arlaneenalra/pi-pico-boards/README.md

# pi-pico-boards
A place to keep various pi-pico-board experiments
