arlaneenalra/pi-pico-boards/reworked/frankless/production/bom.csv

Designator | Footprint | Quantity | Value | LCSC Part #
C1, C10, C11, C12, C15, C18, C19, C20, C21, C22, C23, C24, C25, C26, C28, C36, C37, C38, C39, C42, C43, C5, C6, C9 | 0402 | 24 | 100n | C1525
C13, C14 | 0603 | 2 | 4.7u | C19666
C16, C17 | 0402 | 2 | 4.7u | C2986286
C2, C27, C29, C3, C30, C31, C32, C34, C35, C40, C44 | 0402 | 11 | 10uf | C77000
C33 | CP_EIA-3216-18_Kemet-A | 1 | 10uf tantulum | C7171
C4, C7 | 0603 | 2 | 10uf | C96446
C41 | 0402 | 1 | 1uf | C14445
C8 | 0603 | 1 | 22uf | C59461
D1 | D_SOD-323 | 1 | 1N5819WS | C191023
J2 | JST_SH_1x03_P1.00mm_Vertical | 1 | DEBUG | C160389
J3 | microSD_HC_Molex_104031-0811 | 1 | 1040310811 | C585350
J6 | HDMI-SMD_HC-HDMI0019T-2 | 1 | HC-HDMI0019T-1A | C51927036
J7 | AudioJack_3.5mm_PJ320D | 1 | PJ-320D | C431535
L1 | 0603 | 1 | 120R | C14709
L2 | AOTA-B201610S3R3-101-T | 1 | 3.3u | C42411119
LD1 | 0603 | 1 | KT-0603R | C2286
LD2 | 0603 | 1 | KT-0603W | C2290
R1, R10, R11, R3, R4, R5 | 0402 | 6 | 22R | C25092
R12 | 0402 | 1 | 0R | C17168
R13, R14, R2, R23, R24, R25, R26, R27, R28, R34, R36, R37, R38, R39, R40 | 0402 | 15 | 10K | C25744
R15 | 0402 | 1 | 33R | C25105
R16, R17, R9 | 0402 | 3 | 1K | C11702
R18, R19 | 0201 | 2 | 27R | C473051
R20, R33 | 0402 | 2 | 100R | C25076
R21, R22 | 0402 | 2 | 470R | C25117
R29, R30 | 0402 | 2 | 47K | C25792
R31, R32 | 0402 | 2 | 20K | C25765
R35, R60, R61 | 0402 | 3 | 4.7K | C25900
R6, R7 | 0402 | 2 | 5.1K | C25905
R8 | 0402 | 1 | 1M | C26083
RN1, RN2 | R_Array_Convex_4x0402 | 2 | 270R | C728722
S1 | Switch_Slide_MSK12C02 | 1 | MSK12C02 | C431540
S3, S4 | SW-SMD_4P-L3.5-W3.0-P1.50-LS4.7 | 2 | BUTTON | C49393608
U1 | UQFN-10 | 1 | TS3USB221RSER | C130085
U10 | SOIC-8_3.9x4.9mm_P1.27mm | 1 | DS3231MZ+TRL | C107410
U11 | QSOP-16_3.9x4.9mm_P0.635mm | 1 | CH334R | C4154405
U2 | SOT-23-6 | 1 | USBLC6-2SC6 | C2687116
U3 | SOT-223-3_TabPin2 | 1 | AMS1117-3.3 | C6186
U5 | SOIC-8_L4.9-W3.9-P1.27-LS6.0-BL | 1 | APS6404L-3SQR-SN | C5333729
U6 | SOIC-8 | 1 | W25Q128JVS | C97521
U7 | QFN-60_RP2350A | 1 | RP2350 | C42411118
U9 | SO-8 | 1 | LM358 | C7950
USB1 | USB-A-TH_AF-SS-JB17.6 | 1 | AF SS-JB17.6 | C456021
USB2 | USB-C-SMD_GT-USB-7010B | 1 | USB4215-03-A | C37616412
Y1, Y3 | OSC-SMD_4P-L1.6-W1.2-BL | 2 | ASE-12MHz | C20539386
