arlaneenalra/pi-pico-boards/reworked/frankless/3d/USB_A_Stacked.step

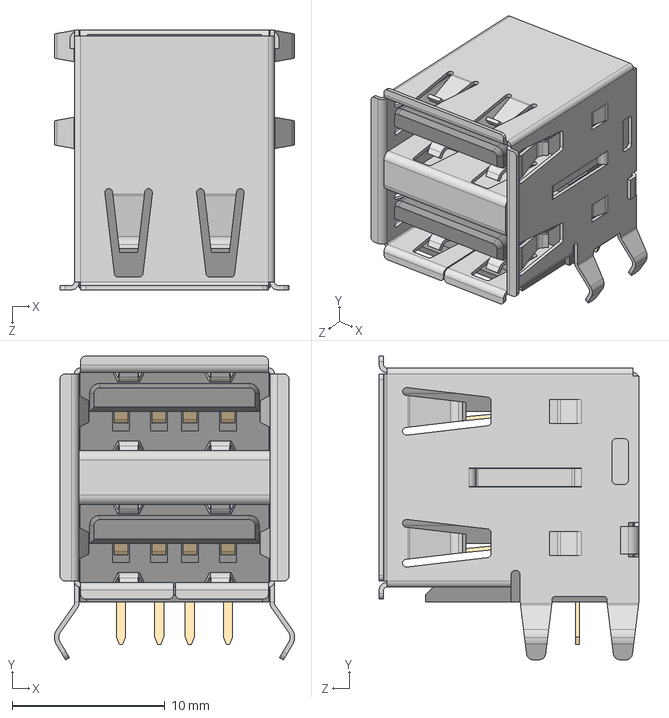
[picture p1: CAD file, 2026-10-11]
reworked/frankless/3d/USB_A_Stacked.step
15.7 x 19.9 x 17.0 mm
