arlaneenalra/pi-pico-boards/reworked/frankless/EASYEDA_MODELS/USB-C-SMD_GT-USB-7010B.step

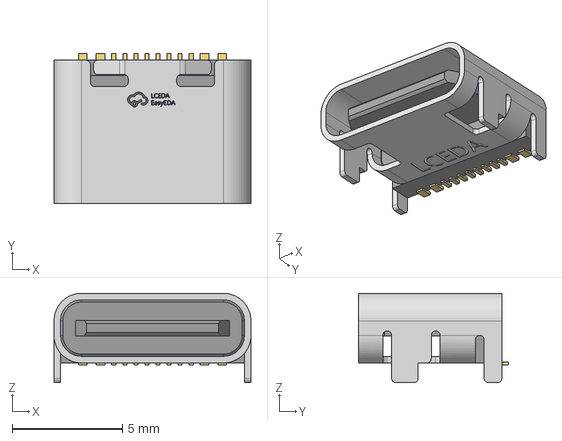
[picture p2: CAD file, 2026-10-12]
reworked/frankless/EASYEDA_MODELS/USB-C-SMD_GT-USB-7010B.step
8.94 x 6.80 x 4.06 mm
