arlaneenalra/pi-pico-boards/reworked/frankless/3d/Switch_Slide_SK12D07VG3NS.step

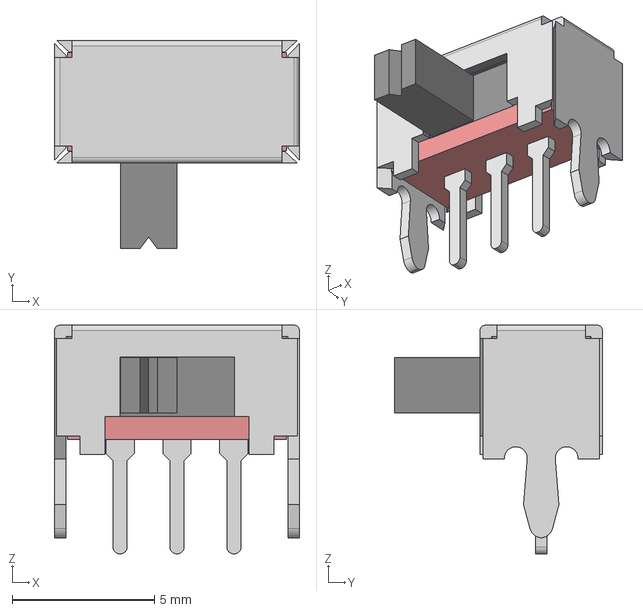
[picture p3: CAD file, 2026-10-11]
reworked/frankless/3d/Switch_Slide_SK12D07VG3NS.step
8.60 x 7.30 x 8.03 mm
