arlaneenalra/pi-pico-boards/reworked/frankless/EASYEDA_MODELS/USB-C_SMD-TYPE-C-31-M-12_1.step

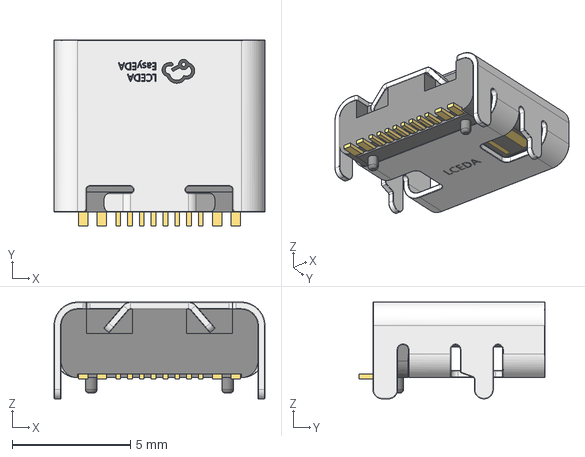
[picture p4: CAD file, 2026-10-12]
reworked/frankless/EASYEDA_MODELS/USB-C_SMD-TYPE-C-31-M-12_1.step
8.94 x 7.90 x 4.10 mm
