arlaneenalra/pi-pico-boards/reworked/frankless/EASYEDA_MODELS/USB-A-TH_AF-SS-JB17.6.step

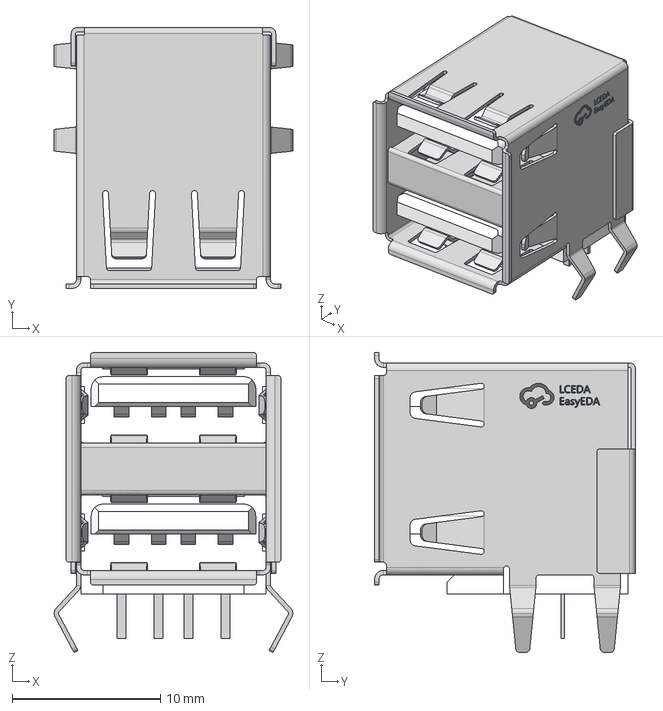
[picture p5: CAD file, 2026-10-12]
reworked/frankless/EASYEDA_MODELS/USB-A-TH_AF-SS-JB17.6.step
16.1 x 17.6 x 20.2 mm
