arlaneenalra/pi-pico-boards/reworked/frankless/EASYEDA_MODELS/CRYSTAL-SMD_4P-L3.2-W2.5-BL.step

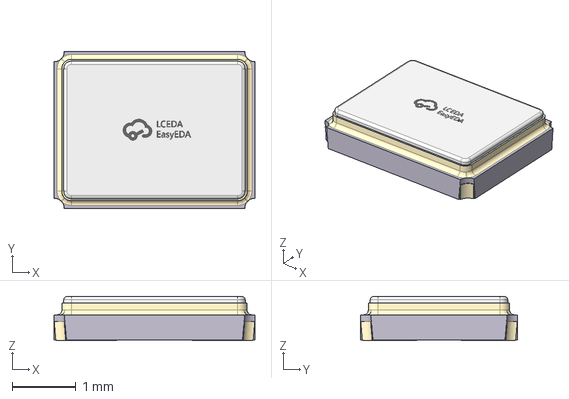
[picture p7: CAD file, 2026-10-11]
reworked/frankless/EASYEDA_MODELS/CRYSTAL-SMD_4P-L3.2-W2.5-BL.step
3.14 x 2.45 x 0.688 mm
