arlaneenalra/pi-pico-boards/reworked/frankless/3d/Switch_Slide_MSK12C02.step

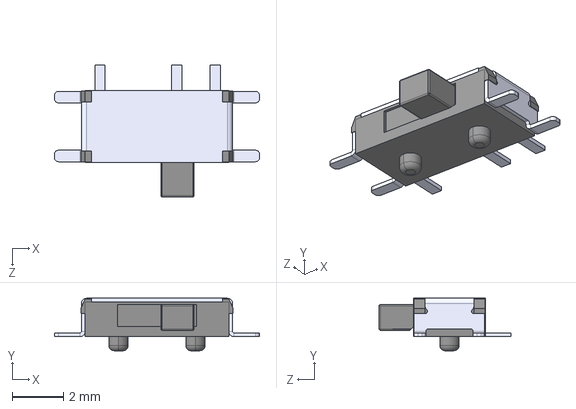
[picture p8: CAD file, 2026-10-11]
reworked/frankless/3d/Switch_Slide_MSK12C02.step
8.00 x 2.05 x 5.15 mm
