arlaneenalra/pi-pico-boards/reworked/frankless/EASYEDA_MODELS/OSC-SMD_4P-L1.6-W1.2-H0.4-BL.step

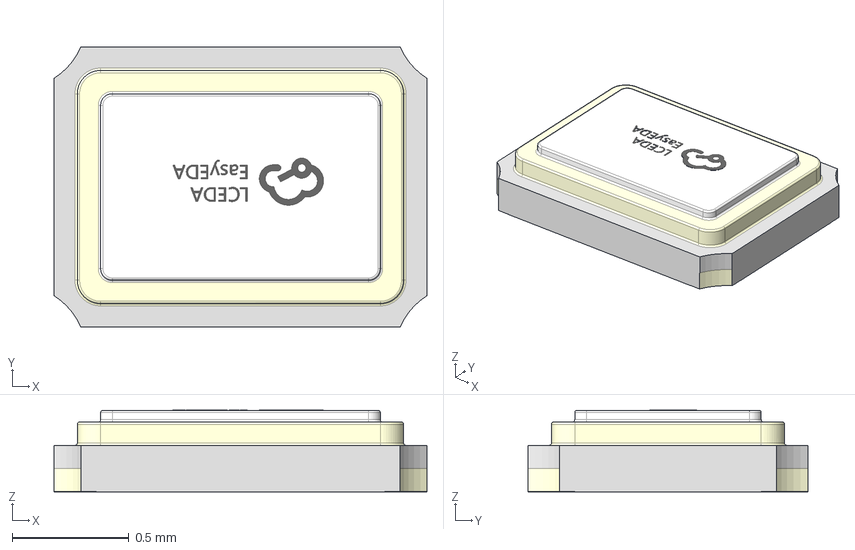
[picture p9: CAD file, 2026-10-11]
reworked/frankless/EASYEDA_MODELS/OSC-SMD_4P-L1.6-W1.2-H0.4-BL.step
1.60 x 1.20 x 0.351 mm
