arlaneenalra/pi-pico-boards/reworked/frankless/3d/UQFN-10_TS3USB221.step

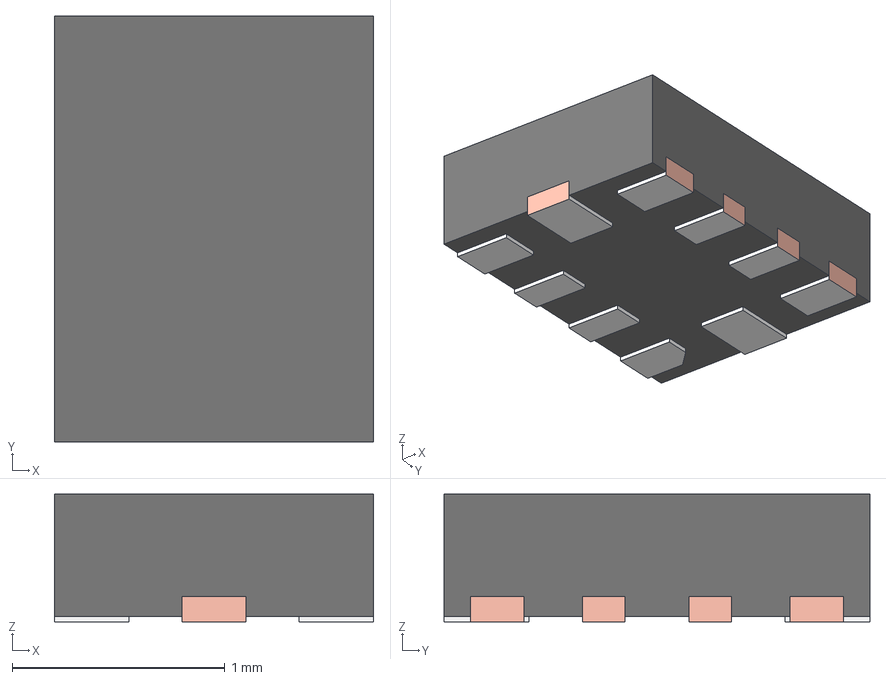
[picture p10: CAD file, 2026-10-11]
reworked/frankless/3d/UQFN-10_TS3USB221.step
1.50 x 2.00 x 0.6 mm
FRAME-RSE0010A
BODY-QFN
PIN1-ID
