arlaneenalra/pi-pico-boards/reworked/frankless/EASYEDA_MODELS/SW-SMD_4P-L3.5-W3.0-H2-P1.50-LS4.7.step

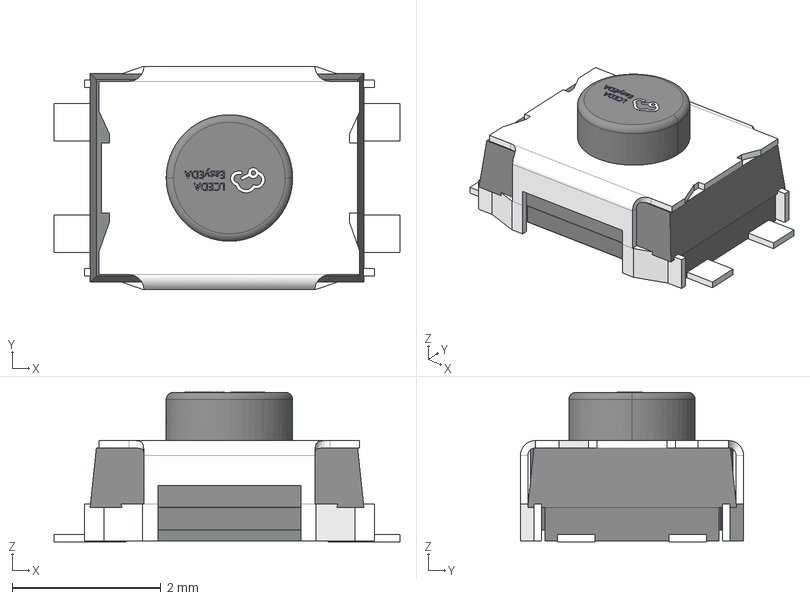
[picture p11: CAD file, 2026-10-11]
reworked/frankless/EASYEDA_MODELS/SW-SMD_4P-L3.5-W3.0-H2-P1.50-LS4.7.step
4.65 x 3.00 x 2.01 mm
