arlaneenalra/pi-pico-boards/reworked/frankless/3d/Button_SMD_3x4x2mm.step

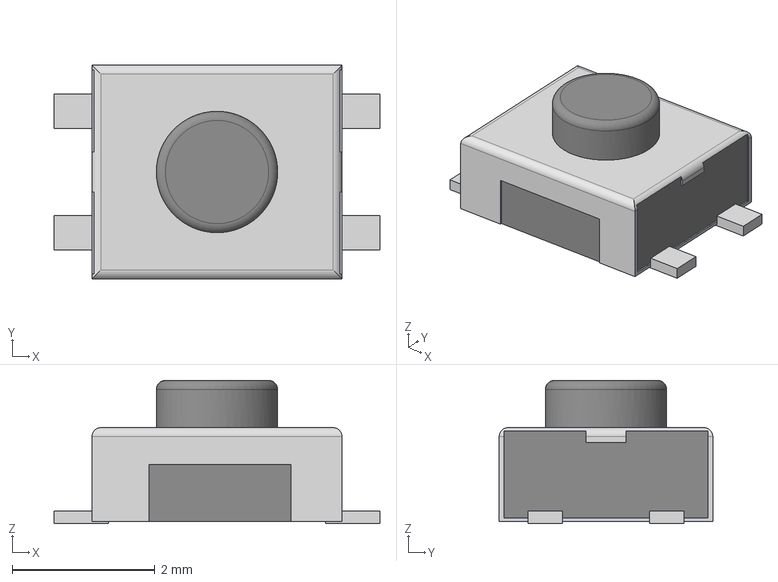
[picture p12: CAD file, 2026-10-11]
reworked/frankless/3d/Button_SMD_3x4x2mm.step
4.57 x 3.00 x 2.01 mm
