arlaneenalra/pi-pico-boards/reworked/frankless/EASYEDA_MODELS/SOIC-8_L4.9-W3.9-H1.7-LS6.0-P1.27.step

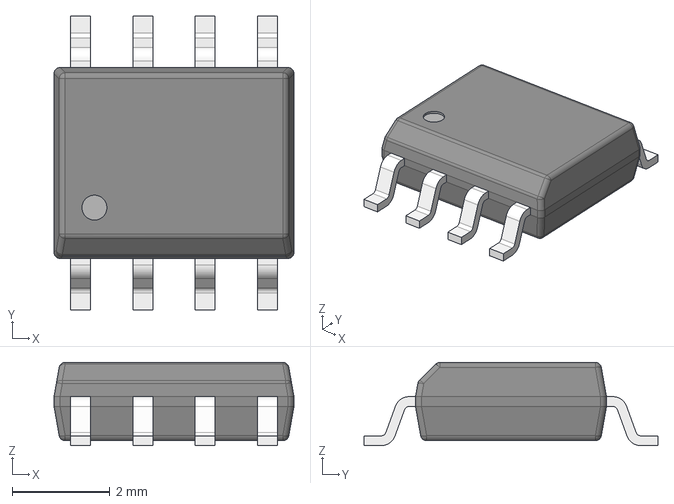
[picture p13: CAD file, 2026-10-11]
reworked/frankless/EASYEDA_MODELS/SOIC-8_L4.9-W3.9-H1.7-LS6.0-P1.27.step
4.90 x 6.00 x 1.70 mm
