arlaneenalra/pi-pico-boards/reworked/frankless/3d/HDMI_Female.step

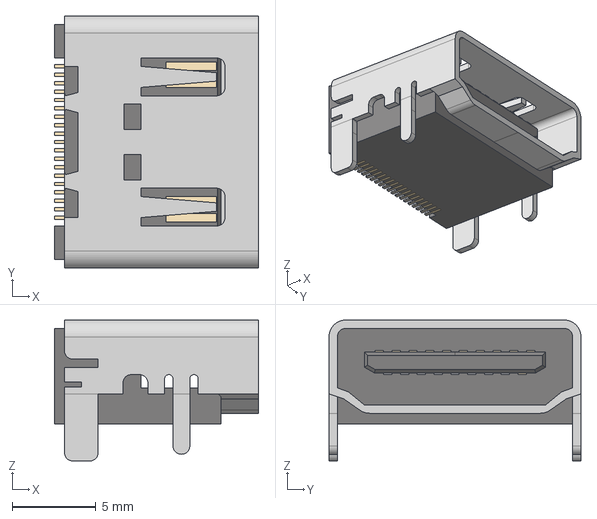
[picture p14: CAD file, 2026-10-11]
reworked/frankless/3d/HDMI_Female.step
12.2 x 15.0 x 8.39 mm
