arlaneenalra/pi-pico-boards/reworked/frankless/EASYEDA_MODELS/HDMI-SMD_A111926-B-01-R.step

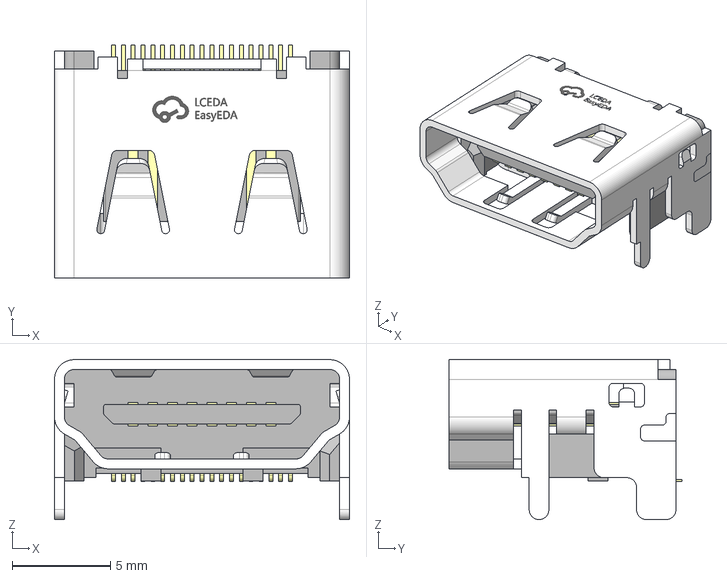
[picture p15: CAD file, 2026-10-11]
reworked/frankless/EASYEDA_MODELS/HDMI-SMD_A111926-B-01-R.step
15.0 x 11.9 x 8.14 mm
