arlaneenalra/pi-pico-boards/reworked/frankless/3d/ESP-01S.step

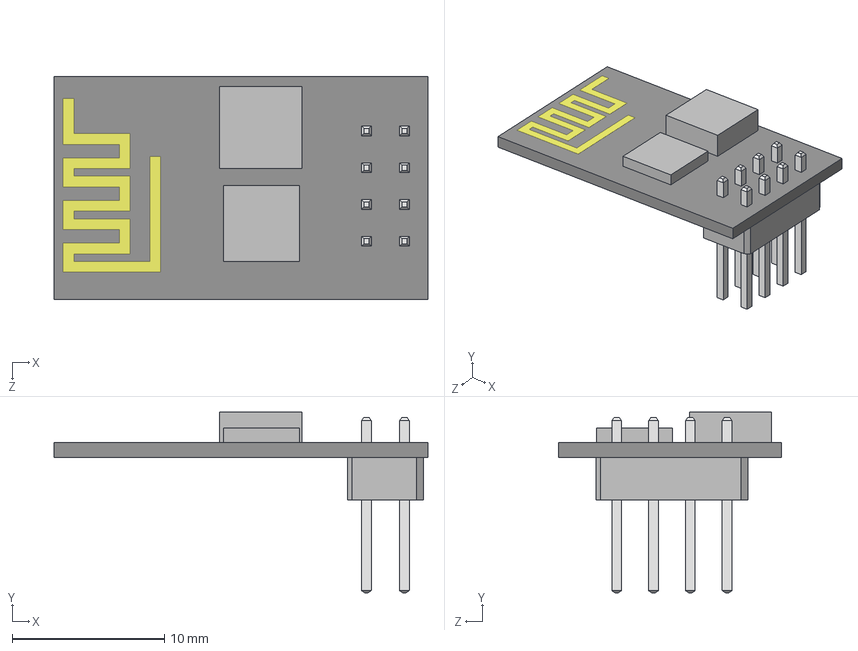
[picture p16: CAD file, 2026-10-11]
reworked/frankless/3d/ESP-01S.step
24.6 x 11.9 x 14.7 mm
