arlaneenalra/pi-pico-boards/reworked/frankless/3d/USB_C_Receptacle.step

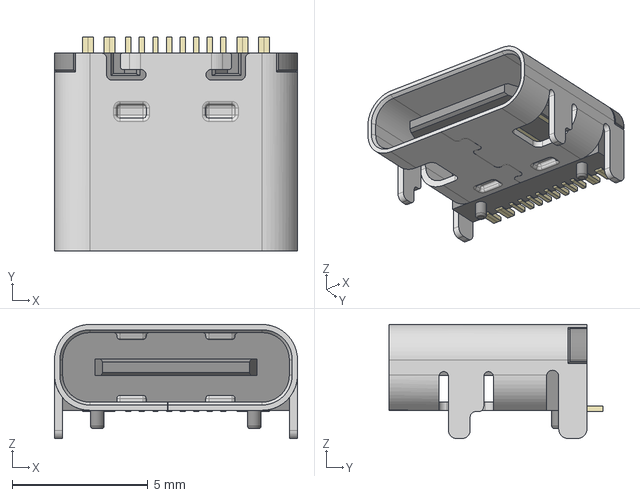
[picture p17: CAD file, 2026-10-11]
reworked/frankless/3d/USB_C_Receptacle.step
8.95 x 7.90 x 4.20 mm
