arlaneenalra/pi-pico-boards/reworked/frankless/3d/Inductor_2016.step

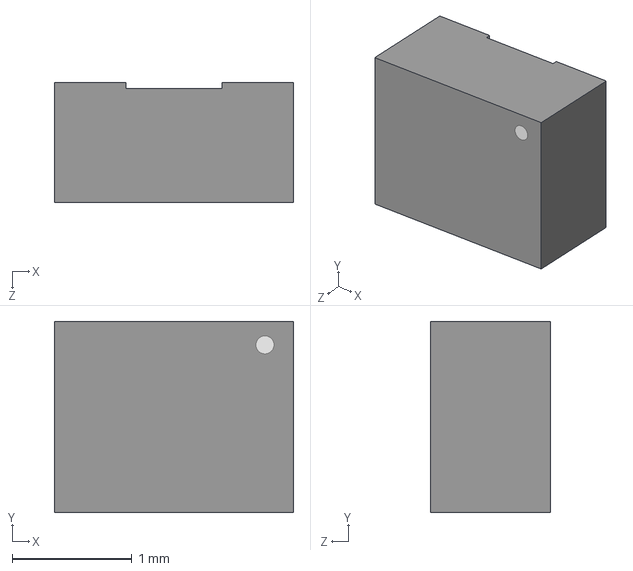
[picture p18: CAD file, 2026-10-11]
reworked/frankless/3d/Inductor_2016.step
2.00 x 1.60 x 1.00 mm
