arlaneenalra/pi-pico-boards/reworked/frankless/3d/SOIC-8_W25Q128.step

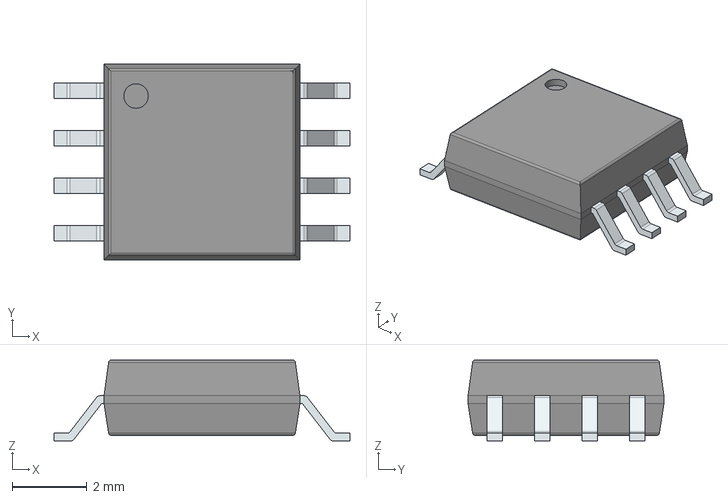
[picture p19: CAD file, 2026-10-11]
reworked/frankless/3d/SOIC-8_W25Q128.step
7.90 x 5.23 x 2.16 mm
PinsArrayLR
