arlaneenalra/pi-pico-boards/reworked/frankless/3d/PinHeader_2x04_P2.54mm.step

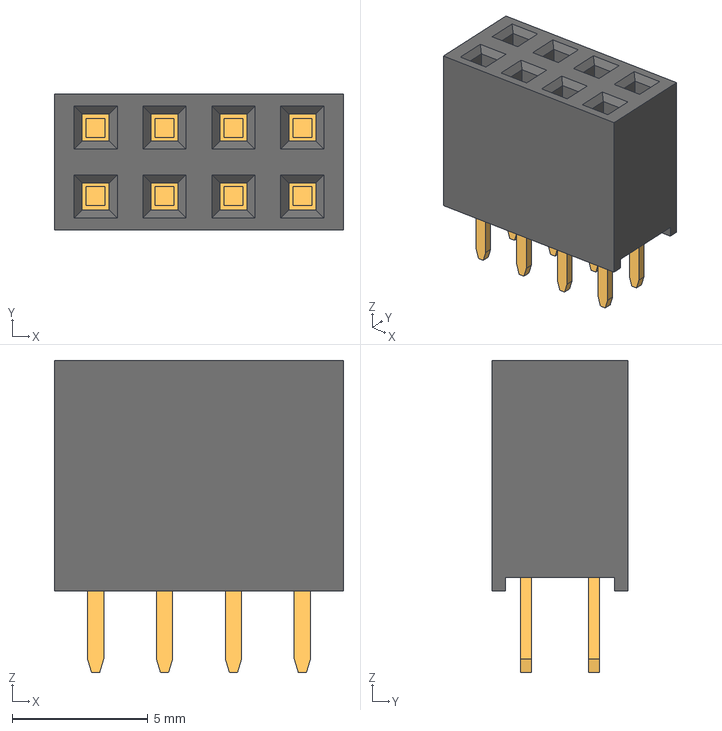
[picture p20: CAD file, 2026-10-11]
reworked/frankless/3d/PinHeader_2x04_P2.54mm.step
10.7 x 5.00 x 11.5 mm
