arlaneenalra/pi-pico-boards/reworked/frankless/3d/MicroSD_SMD_Short.step

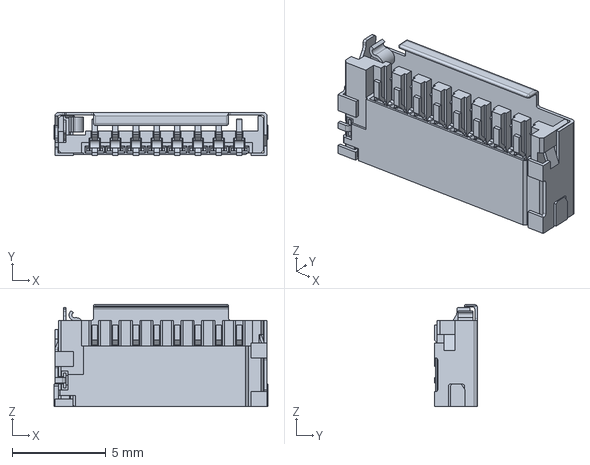
[picture p21: CAD file, 2026-10-11]
reworked/frankless/3d/MicroSD_SMD_Short.step
11.4 x 2.30 x 5.45 mm
