arlaneenalra/pi-pico-boards/reworked/frankless/3d/Oscillator_SMD_3225.step

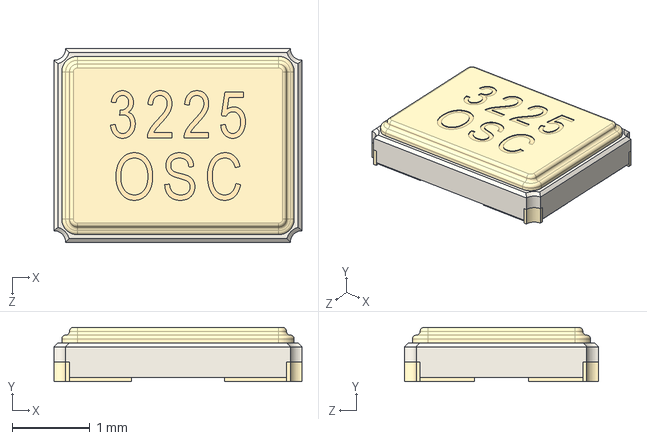
[picture p22: CAD file, 2026-10-11]
reworked/frankless/3d/Oscillator_SMD_3225.step
3.20 x 0.7 x 2.50 mm
