arlaneenalra/pi-pico-boards/(list of files, cad)

Other CAD files:
reworked/frankless/3d/SOP-16.step
reworked/frankless/3d/AudioJack_3.5mm_PJ320D_AudioOut.step
