arlaneenalra/pi-pico-boards/reworked/frankless/frankless.kicad_pcb

## KiCad design reworked/frankless/frankless.kicad_pcb (2026-10-22)

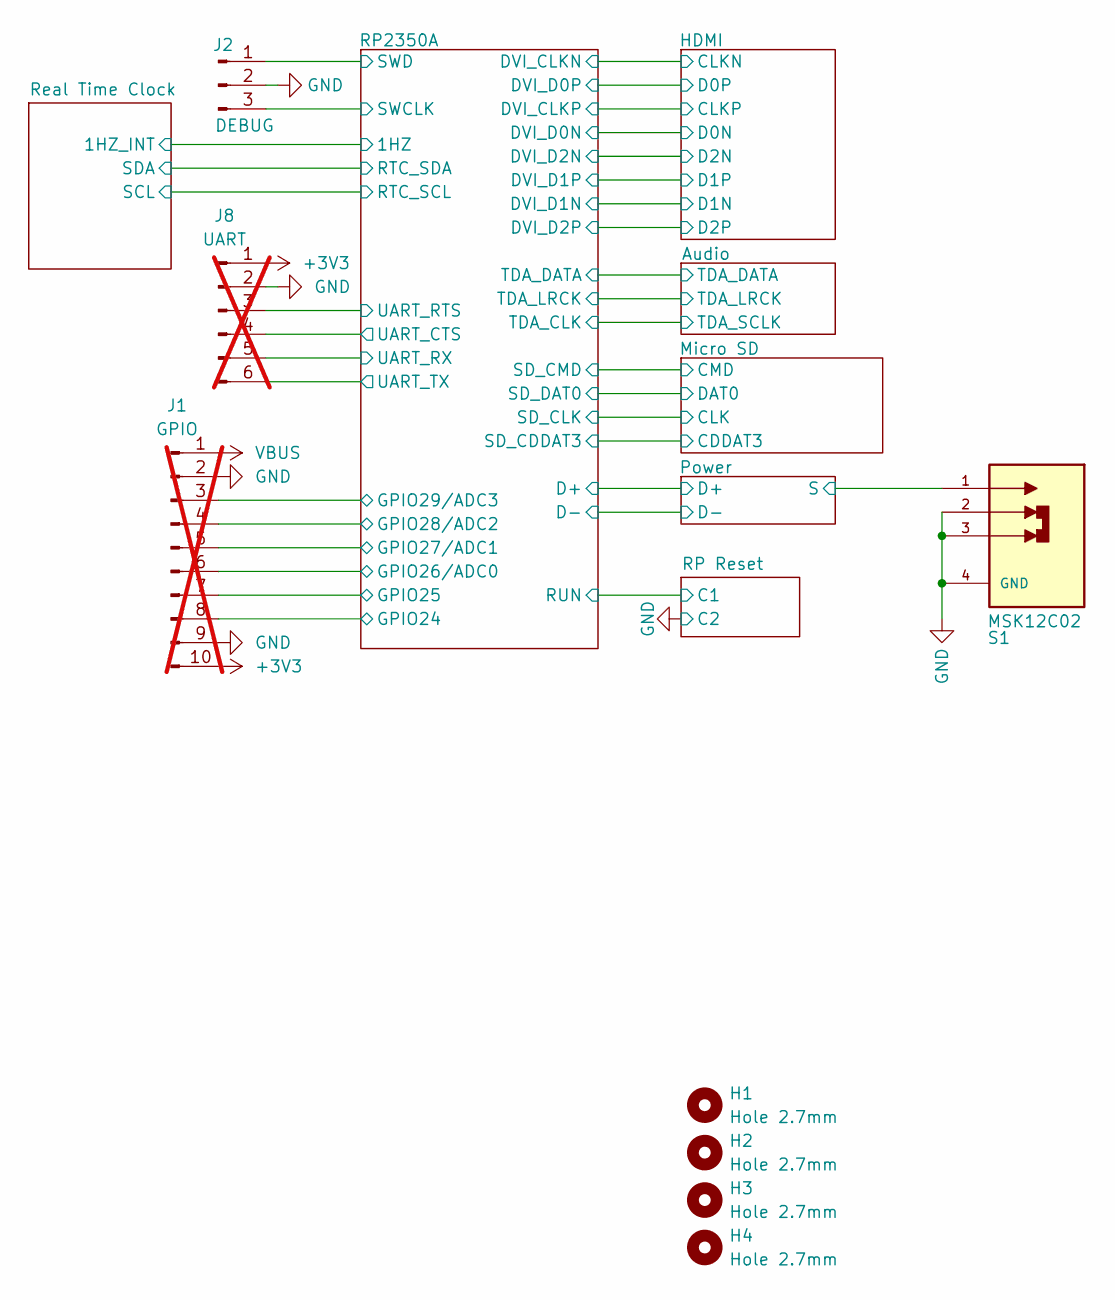
[picture p23: schematic frankless.kicad_sch, ${NAME}]

Parts:
H1, H2, H3, H4: Hole 2.7mm; MountingHole_2.7mm
J1: GPIO; PinHeader_2x05_P2.54mm_Vertical; not fitted
J2: DEBUG; JST_SH_1x03_P1.00mm_Vertical; LCSC Part # C160389
J8: UART; PinHeader_2x03_P2.54mm_Vertical; not fitted
S1: MSK12C02; Switch_Slide_MSK12C02; PARTREV A/0; LCSC Part # C431540

Connections:
+3V3: J1.10, J8.1; also elsewhere on the board
/Power/S: S1.1; also elsewhere on the board
/RP2350A/GPIO24: J1.8; also elsewhere on the board
/RP2350A/GPIO25: J1.7; also elsewhere on the board
/RP2350A/GPIO26/ADC0: J1.6; also elsewhere on the board
/RP2350A/GPIO27/ADC1: J1.5; also elsewhere on the board
/RP2350A/GPIO28/ADC2: J1.4; also elsewhere on the board
/RP2350A/GPIO29/ADC3: J1.3; also elsewhere on the board
/RP2350A/SWCLK: J2.3; also elsewhere on the board
/RP2350A/SWD: J2.1; also elsewhere on the board
/RP2350A/UART_CTS: J8.4; also elsewhere on the board
/RP2350A/UART_RTS: J8.3; also elsewhere on the board
/RP2350A/UART_RX: J8.5; also elsewhere on the board
/RP2350A/UART_TX: J8.6; also elsewhere on the board
GND: J1.2, J1.9, J2.2, J8.2, S1.2, S1.3, S1.4 (GND_4); also elsewhere on the board
VBUS: J1.1; also elsewhere on the board

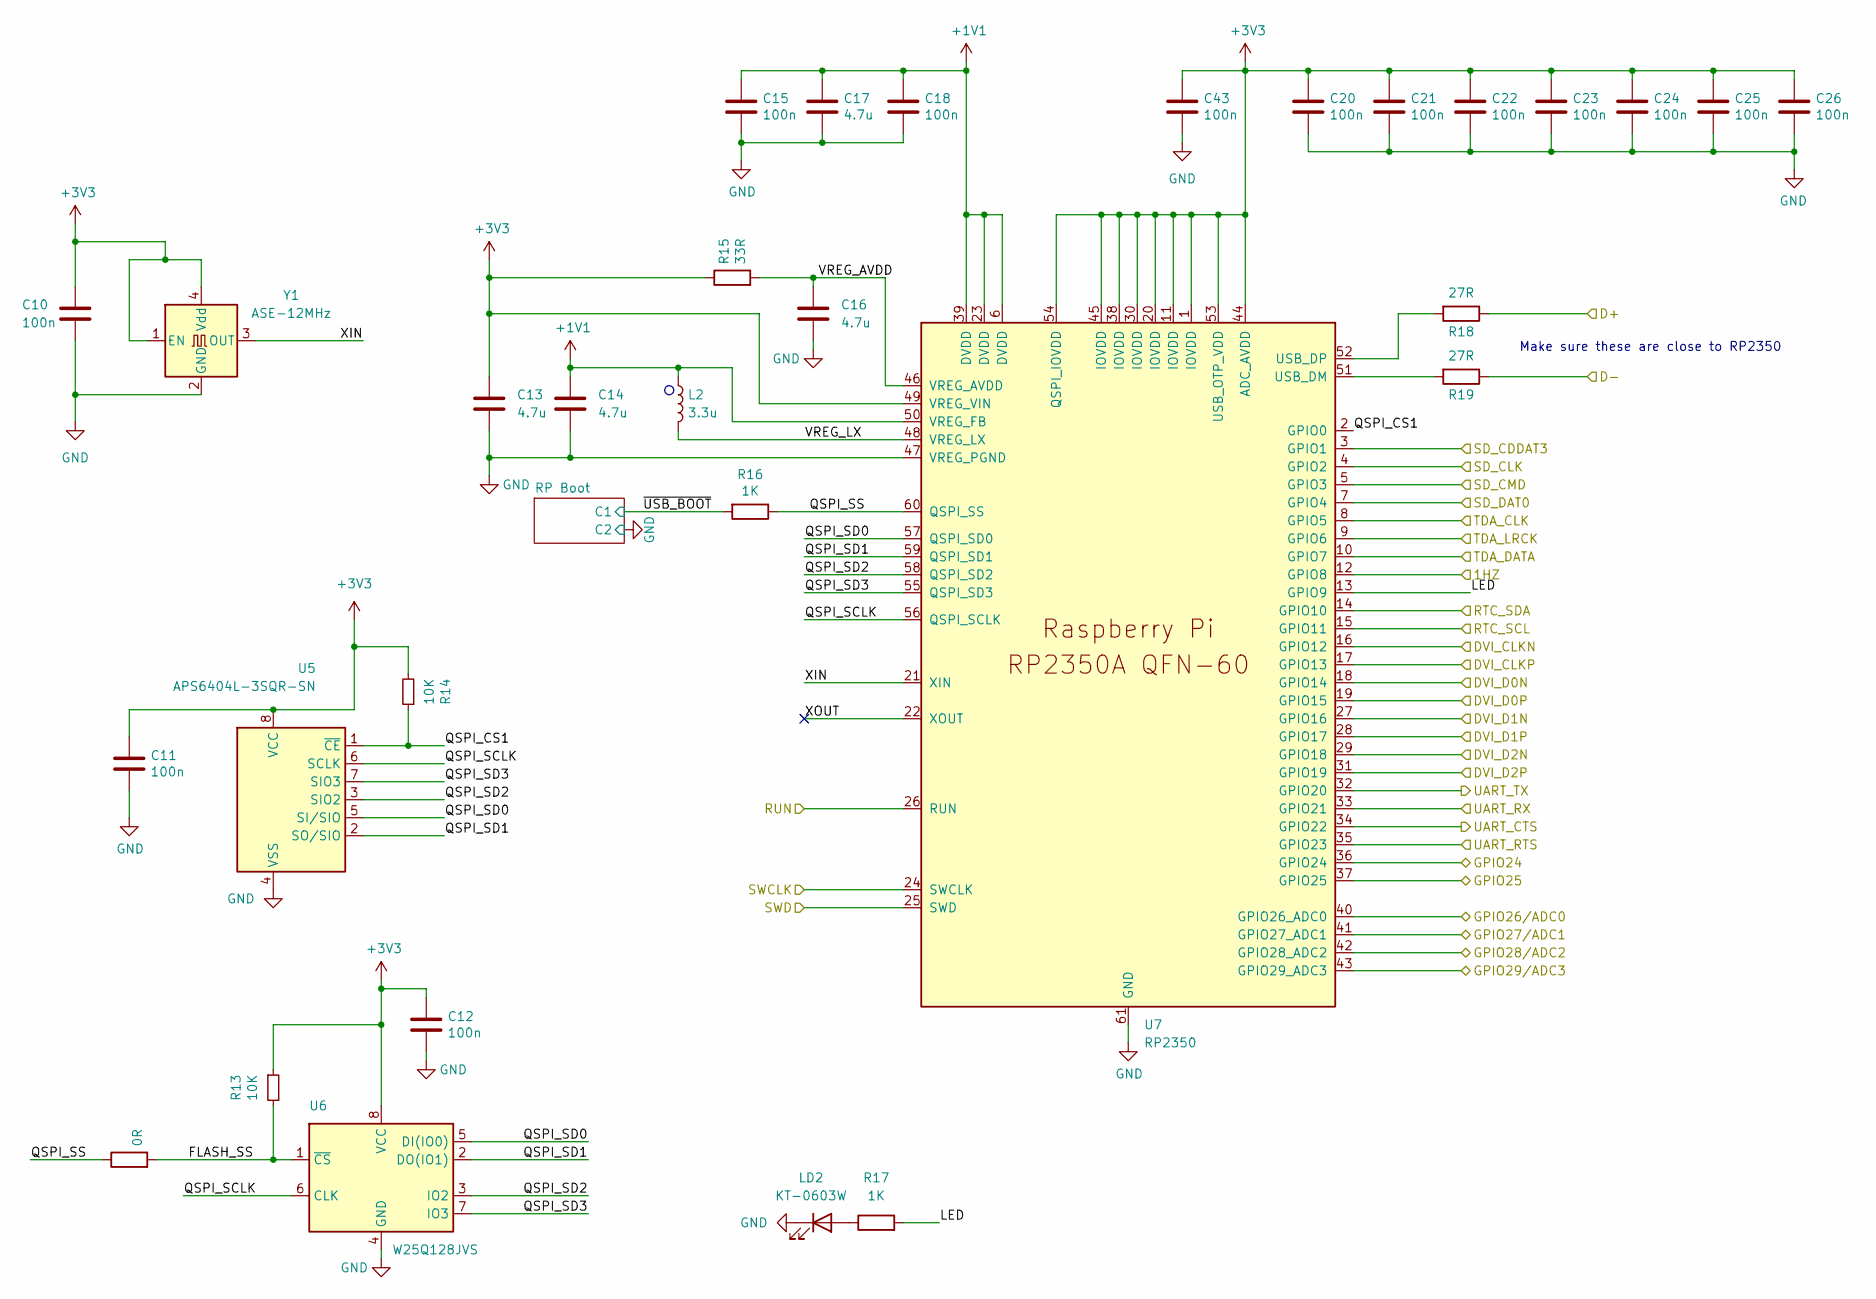
[picture p24: schematic rp2350a.kicad_sch, ${NAME}]

Parts:
C10, C11, C12, C15, C18, C20, C21, C22, C23, C24, C25, C26, C43: 100n; C_0402_1005Metric; LCSC Part # C1525
C13, C14: 4.7u; C_0603_1608Metric; LCSC Part # C19666
C16, C17: 4.7u; C_0402_1005Metric; LCSC Part # C2986286
L2: 3.3u; AOTA-B201610S3R3-101-T; LCSC Part # C42411119
LD2: KT-0603W; LED_0603_1608Metric; LCSC Part # C2290
R12: 0R; R_0402_1005Metric; LCSC Part # C17168
R13, R14: 10K; R_0402_1005Metric; LCSC Part # C25744
R15: 33R; R_0402_1005Metric; LCSC Part # C25105
R16, R17: 1K; R_0402_1005Metric; LCSC Part # C11702
R18, R19: 27R; R_0201_0603Metric; LCSC Part # C473051
U5: APS6404L-3SQR-SN; SOIC-8_L4.9-W3.9-P1.27-LS6.0-BL; LCSC Part # C5333729
U6: W25Q128JVS; SOIC-8; LCSC Part # C97521
U7: RP2350; QFN-60_RP2350A; LCSC Part # C42411118
Y1: ASE-12MHz; OSC-SMD_4P-L1.6-W1.2-BL; LCSC Part # C20539386

Connections:
+1V1: C14.1, C15.1, C17.1, C18.1, L2.1, U7.6 (DVDD), U7.23 (DVDD), U7.39 (DVDD), U7.50 (VREG_FB)
+3V3: C10.1, C11.1, C12.1, C13.1, C20.1, C21.1, C22.1, C23.1, C24.1, C25.1, C26.1, C43.1, R13.1, R14.2, R15.1, U5.8 (VCC), U6.8 (VCC), U7.1 (IOVDD), U7.11 (IOVDD), U7.20 (IOVDD), U7.30 (IOVDD), U7.38 (IOVDD), U7.44 (ADC_AVDD), U7.45 (IOVDD), U7.49 (VREG_VIN), U7.53 (USB_OTP_VDD), U7.54 (QSPI_IOVDD), Y1.1 (EN), Y1.4 (Vdd); also elsewhere on the board
/Audio/TDA_DATA: U7.10 (GPIO7); also elsewhere on the board
/Audio/TDA_LRCK: U7.9 (GPIO6); also elsewhere on the board
/Audio/TDA_SCLK: U7.8 (GPIO5); also elsewhere on the board
/HDMI/CLKN: U7.16 (GPIO12); also elsewhere on the board
/HDMI/CLKP: U7.17 (GPIO13); also elsewhere on the board
/HDMI/D0N: U7.18 (GPIO14); also elsewhere on the board
/HDMI/D0P: U7.19 (GPIO15); also elsewhere on the board
/HDMI/D1N: U7.27 (GPIO16); also elsewhere on the board
/HDMI/D1P: U7.28 (GPIO17); also elsewhere on the board
/HDMI/D2N: U7.29 (GPIO18); also elsewhere on the board
/HDMI/D2P: U7.31 (GPIO19); also elsewhere on the board
/Micro SD/CDDAT3: U7.3 (GPIO1); also elsewhere on the board
/Micro SD/CLK: U7.4 (GPIO2); also elsewhere on the board
/Micro SD/CMD: U7.5 (GPIO3); also elsewhere on the board
/Micro SD/DAT0: U7.7 (GPIO4); also elsewhere on the board
/Power/D+: R18.1; also elsewhere on the board
/Power/D-: R19.1; also elsewhere on the board
/RP2350A/1HZ: U7.12 (GPIO8); also elsewhere on the board
/RP2350A/FLASH_SS: R12.2, R13.2, U6.1 (~CS)
/RP2350A/GPIO24: U7.36 (GPIO24); also elsewhere on the board
/RP2350A/GPIO25: U7.37 (GPIO25); also elsewhere on the board
/RP2350A/GPIO26/ADC0: U7.40 (GPIO26_ADC0); also elsewhere on the board
/RP2350A/GPIO27/ADC1: U7.41 (GPIO27_ADC1); also elsewhere on the board
/RP2350A/GPIO28/ADC2: U7.42 (GPIO28_ADC2); also elsewhere on the board
/RP2350A/GPIO29/ADC3: U7.43 (GPIO29_ADC3); also elsewhere on the board
/RP2350A/LED: R17.2, U7.13 (GPIO9)
/RP2350A/QSPI_CS1: R14.1, U5.1 (~CE), U7.2 (GPIO0)
/RP2350A/QSPI_SCLK: U5.6 (SCLK), U6.6 (CLK), U7.56 (QSPI_SCLK)
/RP2350A/QSPI_SD0: U5.5 (SI/SIO), U6.5 (DI(IO0)), U7.57 (QSPI_SD0)
/RP2350A/QSPI_SD1: U5.2 (SO/SIO), U6.2 (DO(IO1)), U7.59 (QSPI_SD1)
/RP2350A/QSPI_SD2: U5.3 (SIO2), U6.3 (IO2), U7.58 (QSPI_SD2)
/RP2350A/QSPI_SD3: U5.7 (SIO3), U6.7 (IO3), U7.55 (QSPI_SD3)
/RP2350A/QSPI_SS: R12.1, R16.1, U7.60 (QSPI_SS)
/RP2350A/RTC_SCL: U7.15 (GPIO11); also elsewhere on the board
/RP2350A/RTC_SDA: U7.14 (GPIO10); also elsewhere on the board
/RP2350A/SWCLK: U7.24 (SWCLK); also elsewhere on the board
/RP2350A/SWD: U7.25 (SWD); also elsewhere on the board
/RP2350A/UART_CTS: U7.34 (GPIO22); also elsewhere on the board
/RP2350A/UART_RTS: U7.35 (GPIO23); also elsewhere on the board
/RP2350A/UART_RX: U7.33 (GPIO21); also elsewhere on the board
/RP2350A/UART_TX: U7.32 (GPIO20); also elsewhere on the board
/RP2350A/VREG_AVDD: C16.1, R15.2, U7.46 (VREG_AVDD)
/RP2350A/VREG_LX: L2.2, U7.48 (VREG_LX)
/RP2350A/XIN: U7.21 (XIN), Y1.3 (OUT)
/RP2350A/XOUT: U7.22 (XOUT)
/RP2350A/~USB_BOOT: R16.2; also elsewhere on the board
/RP Reset/C1: U7.26 (RUN); also elsewhere on the board
GND: C10.2, C11.2, C12.2, C13.2, C14.2, C15.2, C16.2, C17.2, C18.2, C20.2, C21.2, C22.2, C23.2, C24.2, C25.2, C26.2, C43.2, LD2.1 (K), U5.4 (VSS), U6.4 (GND), U7.47 (VREG_PGND), U7.61 (GND), Y1.2 (GND); also elsewhere on the board
unnamed: LD2.2 (A), R17.1
unnamed: R19.2, U7.51 (USB_DM)
unnamed: R18.2, U7.52 (USB_DP)

Notes on the sheet:
Make sure these are close to RP2350

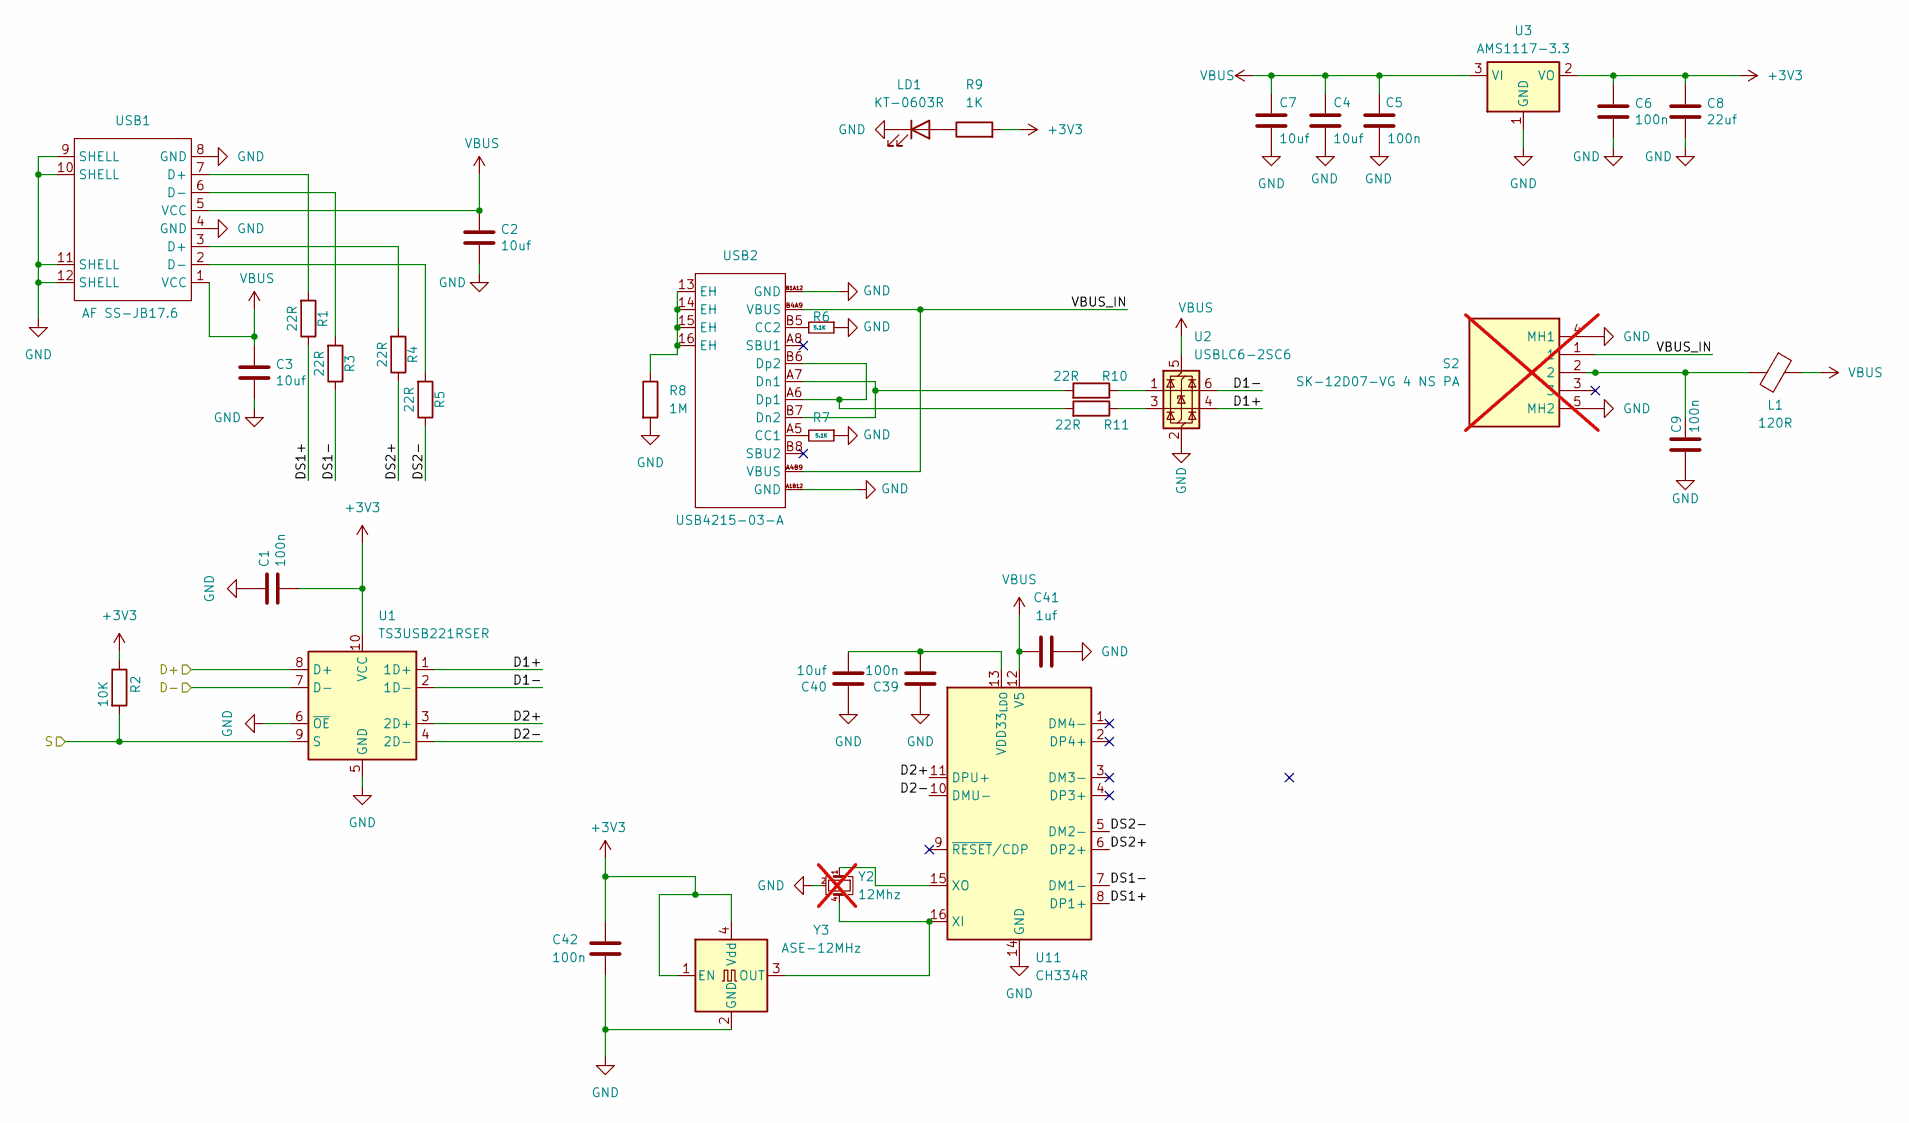
[picture p25: schematic power.kicad_sch, ${NAME}]

Parts:
C1, C5, C6, C9, C39, C42: 100n; C_0402_1005Metric; LCSC Part # C1525
C2, C3, C40: 10uf; C_0402_1005Metric; LCSC Part # C77000
C4, C7: 10uf; C_0603_1608Metric; LCSC Part # C96446
C8: 22uf; C_0603_1608Metric; LCSC Part # C59461
C41: 1uf; C_0402_1005Metric; LCSC Part # C14445
L1: 120R; L_0603_1608Metric; LCSC Part # C14709
LD1: KT-0603R; LED_0603_1608Metric; LCSC Part # C2286
R1, R3, R4, R5, R10, R11: 22R; R_0402_1005Metric; LCSC Part # C25092
R2: 10K; R_0402_1005Metric; LCSC Part # C25744
R6, R7: 5.1K; R_0402_1005Metric; LCSC Part # C25905
R8: 1M; R_0402_1005Metric; LCSC Part # C26083
R9: 1K; R_0402_1005Metric; LCSC Part # C11702
S2: SK-12D07-VG 4 NS PA; Switch_Slide_SK12D07VG3NS; Mouser Part Number 611-SK12D07VG3NS; not fitted
U1: TS3USB221RSER; UQFN-10; LCSC Part # C130085
U2: USBLC6-2SC6; SOT-23-6; LCSC Part # C2687116
U3: AMS1117-3.3; SOT-223-3_TabPin2; LCSC Part # C6186
U11: CH334R; QSOP-16_3.9x4.9mm_P0.635mm; LCSC Part # C4154405
USB1: AF SS-JB17.6; USB-A-TH_AF-SS-JB17.6; Manufacturer Part AF SS-JB17.6; LCSC Part Name Type-A 母 弯插
USB2: USB4215-03-A; USB-C-SMD_GT-USB-7010B; Manufacturer Part USB4215-03-A; LCSC Part Name Type-C 母
Y2: 12Mhz; CRYSTAL-SMD_4P-L3.2-W2.5-BL; LCSC Part # C9002; not fitted
Y3: ASE-12MHz; OSC-SMD_4P-L1.6-W1.2-BL; LCSC Part # C20539386

Connections:
+3V3: C1.2, C6.1, C8.1, C42.1, R2.1, R9.2, U1.10 (VCC), U3.2 (VO), Y3.1 (EN), Y3.4 (Vdd); also elsewhere on the board
/Power/D1+: U1.1 (1D+), U2.4 (I/O2)
/Power/D1-: U1.2 (1D-), U2.6 (I/O1)
/Power/D2+: U1.3 (2D+), U11.11 (DPU+)
/Power/D2-: U1.4 (2D-), U11.10 (DMU-)
/Power/D+: U1.8 (D+); also elsewhere on the board
/Power/D-: U1.7 (D-); also elsewhere on the board
/Power/DS1+: R1.1, U11.8 (DP1+)
/Power/DS1-: R3.1, U11.7 (DM1-)
/Power/DS2+: R4.1, U11.6 (DP2+)
/Power/DS2-: R5.1, U11.5 (DM2-)
/Power/S: R2.2, U1.9 (S); also elsewhere on the board
/Power/VBUS_IN: S2.1, USB2.A4B9 (VBUS), USB2.B4A9 (VBUS)
GND: C1.1, C2.2, C3.2, C4.1, C5.1, C6.2, C7.1, C8.2, C9.2, C39.1, C40.1, C41.2, C42.2, LD1.1 (K), R6.1, R7.1, R8.2, S2.4 (MH1), S2.5 (MH2), U1.5 (GND), U1.6 (~OE), U2.2 (GND), U3.1 (GND), U11.14 (GND), USB1.4 (GND), USB1.8 (GND), USB1.9 (SHELL), USB1.10 (SHELL), USB1.11 (SHELL), USB1.12 (SHELL), USB2.A1B12 (GND), USB2.B1A12 (GND), Y2.2 (G), Y2.3 (G), Y3.2 (GND); also elsewhere on the board
unnamed: C9.1, L1.2, S2.2
unnamed: LD1.2 (A), R9.1
unnamed: R1.2, USB1.7 (D+)
unnamed: R3.2, USB1.6 (D-)
unnamed: R4.2, USB1.3 (D+)
unnamed: R5.2, USB1.2 (D-)
unnamed: R8.1, USB2.13 (EH), USB2.14 (EH), USB2.15 (EH), USB2.16 (EH)
unnamed: R10.1, U2.1 (I/O1)
unnamed: R11.1, U2.3 (I/O2)
unnamed: C39.2, C40.2, U11.13 (VDD33_{LDO})
unnamed: U11.16 (XI), Y2.4, Y3.3 (OUT)
unnamed: U11.15 (XO), Y2.1
unnamed: R7.2, USB2.A5 (CC1)
unnamed: R6.2, USB2.B5 (CC2)
unnamed: R10.2, USB2.A7 (Dn1), USB2.B7 (Dn2)
unnamed: R11.2, USB2.A6 (Dp1), USB2.B6 (Dp2)
VBUS: C2.1, C3.1, C4.2, C5.2, C7.2, C41.1, L1.1, U2.5 (VBUS), U3.3 (VI), U11.12 (V5), USB1.1 (VCC), USB1.5 (VCC); also elsewhere on the board

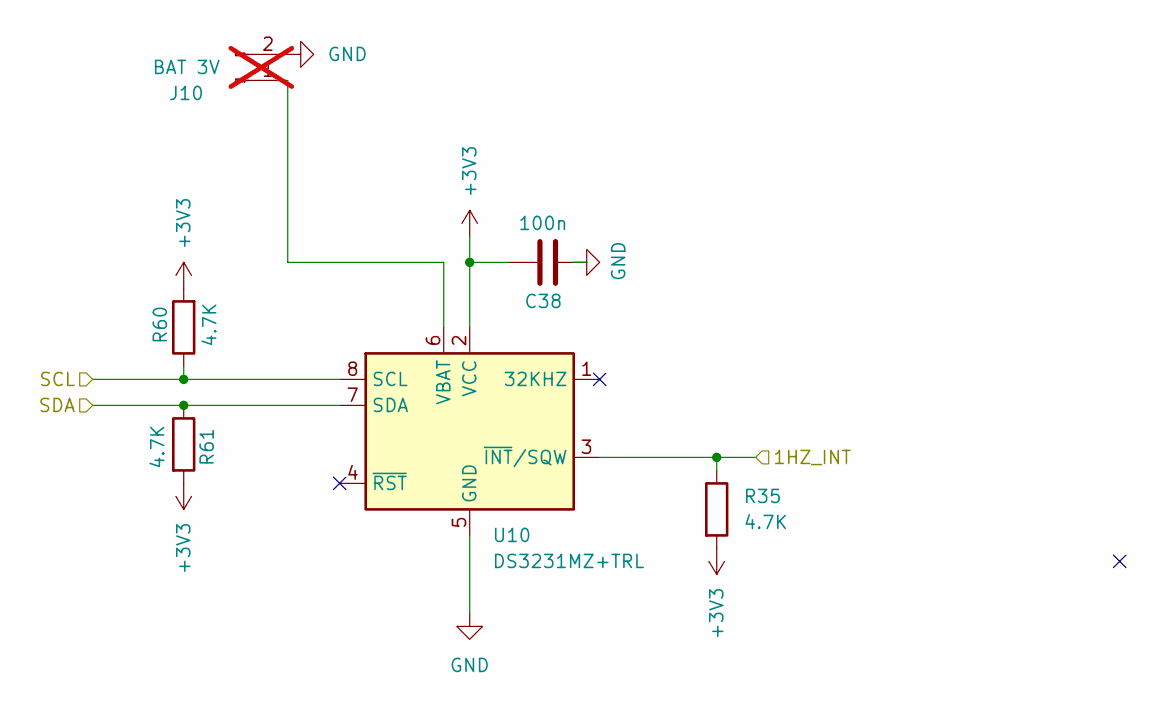
[picture p26: schematic RealTimeClock.kicad_sch]

Parts:
C38: 100n; C_0402_1005Metric; LCSC Part # C1525
J10: BAT 3V; PinHeader_1x02_P2.54mm_Vertical; not fitted
R35, R60, R61: 4.7K; R_0402_1005Metric; LCSC Part # C25900
U10: DS3231MZ+TRL; SOIC-8_3.9x4.9mm_P1.27mm; LCSC Part # C107410

Connections:
+3V3: C38.1, R35.2, R60.2, R61.2, U10.2 (VCC); also elsewhere on the board
/RP2350A/1HZ: R35.1, U10.3 (~INT/SQW); also elsewhere on the board
/RP2350A/RTC_SCL: R60.1, U10.8 (SCL); also elsewhere on the board
/RP2350A/RTC_SDA: R61.1, U10.7 (SDA); also elsewhere on the board
GND: C38.2, J10.2, U10.5 (GND); also elsewhere on the board
unnamed: J10.1, U10.6 (VBAT)

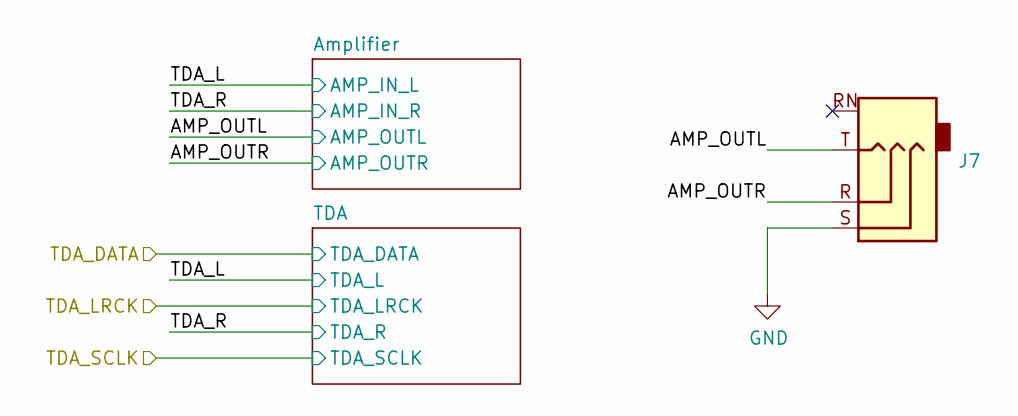
[picture p27: schematic audio.kicad_sch, ${NAME}]

Parts:
J7: PJ-320D; AudioJack_3.5mm_PJ320D; LCSC Part # C431535

Connections:
/Audio/AMP_OUTL: J7.T; also elsewhere on the board
/Audio/AMP_OUTR: J7.R; also elsewhere on the board
GND: J7.S; also elsewhere on the board

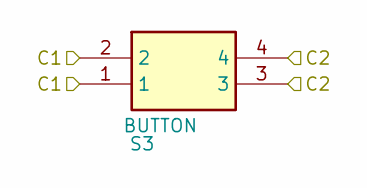
[picture p28: schematic button.kicad_sch, ${NAME}]

Parts:
S3: BUTTON; SW-SMD_4P-L3.5-W3.0-P1.50-LS4.7; Mouser Part Number 611-KMR221G-LFS

Connections:
/RP Reset/C1: S3.1, S3.2; also elsewhere on the board
GND: S3.3, S3.4; also elsewhere on the board

Parts of its further copies:
S4: BUTTON; SW-SMD_4P-L3.5-W3.0-P1.50-LS4.7; Mouser Part Number 611-KMR221G-LFS

Connections of its further copies:
/RP2350A/~USB_BOOT: S4.1, S4.2; also elsewhere on the board
GND: S4.3, S4.4; also elsewhere on the board

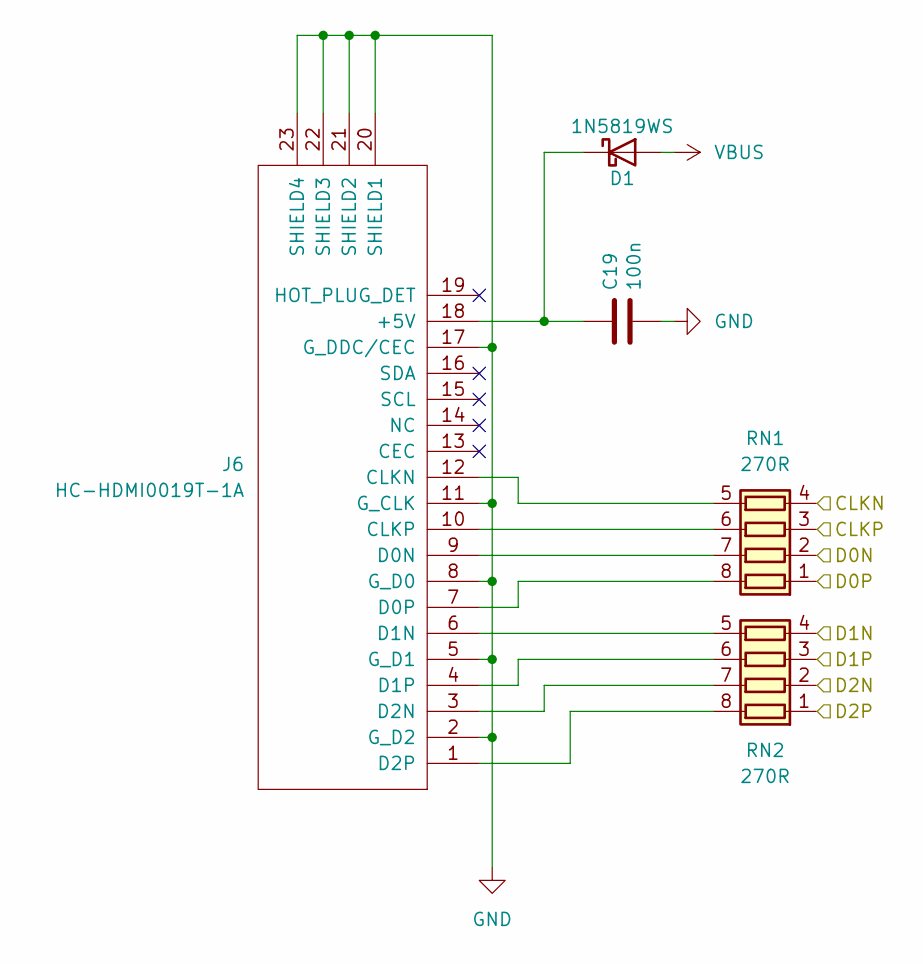
[picture p29: schematic hdmi.kicad_sch, ${NAME}]

Parts:
C19: 100n; C_0402_1005Metric; LCSC Part # C1525
D1: 1N5819WS; D_SOD-323; LCSC Part # C191023
J6: HC-HDMI0019T-1A; HDMI-SMD_HC-HDMI0019T-2; LCSC Part # C51927036
RN1, RN2: 270R; R_Array_Convex_4x0402; LCSC Part # C728722

Connections:
/HDMI/CLKN: RN1.4 (R4.1); also elsewhere on the board
/HDMI/CLKP: RN1.3 (R3.1); also elsewhere on the board
/HDMI/D0N: RN1.2 (R2.1); also elsewhere on the board
/HDMI/D0P: RN1.1 (R1.1); also elsewhere on the board
/HDMI/D1N: RN2.4 (R4.1); also elsewhere on the board
/HDMI/D1P: RN2.3 (R3.1); also elsewhere on the board
/HDMI/D2N: RN2.2 (R2.1); also elsewhere on the board
/HDMI/D2P: RN2.1 (R1.1); also elsewhere on the board
GND: C19.2, J6.2 (G_D2), J6.5 (G_D1), J6.8 (G_D0), J6.11 (G_CLK), J6.17 (G_DDC/CEC), J6.20 (SHIELD1), J6.21 (SHIELD2), J6.22 (SHIELD3), J6.23 (SHIELD4); also elsewhere on the board
unnamed: C19.1, D1.1 (K), J6.18 (+5V)
unnamed: J6.12 (CLKN), RN1.5 (R4.2)
unnamed: J6.10 (CLKP), RN1.6 (R3.2)
unnamed: J6.9 (D0N), RN1.7 (R2.2)
unnamed: J6.7 (D0P), RN1.8 (R1.2)
unnamed: J6.6 (D1N), RN2.5 (R4.2)
unnamed: J6.4 (D1P), RN2.6 (R3.2)
unnamed: J6.3 (D2N), RN2.7 (R2.2)
unnamed: J6.1 (D2P), RN2.8 (R1.2)
VBUS: D1.2 (A); also elsewhere on the board

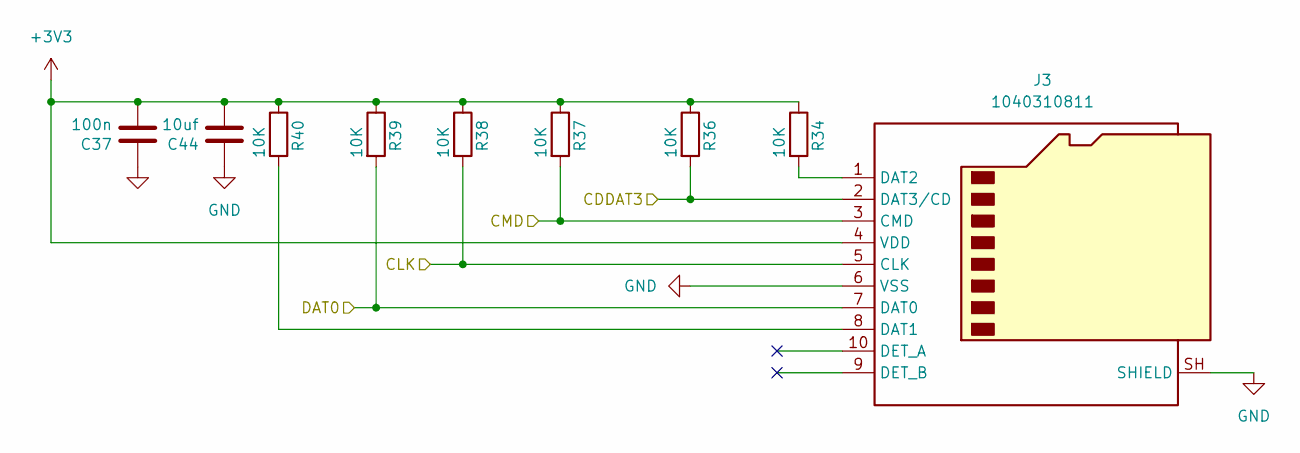
[picture p30: schematic sd.kicad_sch, ${NAME}]

Parts:
C37: 100n; C_0402_1005Metric; LCSC Part # C1525
C44: 10uf; C_0402_1005Metric; LCSC Part # C77000
J3: 1040310811; microSD_HC_Molex_104031-0811; LCSC Part # C585350
R34, R36, R37, R38, R39, R40: 10K; R_0402_1005Metric; LCSC Part # C25744

Connections:
+3V3: C37.2, C44.2, J3.4 (VDD), R34.1, R36.1, R37.1, R38.1, R39.1, R40.1; also elsewhere on the board
/Micro SD/CDDAT3: J3.2 (DAT3/CD), R36.2; also elsewhere on the board
/Micro SD/CLK: J3.5 (CLK), R38.2; also elsewhere on the board
/Micro SD/CMD: J3.3 (CMD), R37.2; also elsewhere on the board
/Micro SD/DAT0: J3.7 (DAT0), R39.2; also elsewhere on the board
GND: C37.1, C44.1, J3.6 (VSS), J3.SH (SHIELD); also elsewhere on the board
unnamed: J3.8 (DAT1), R40.2
unnamed: J3.1 (DAT2), R34.2

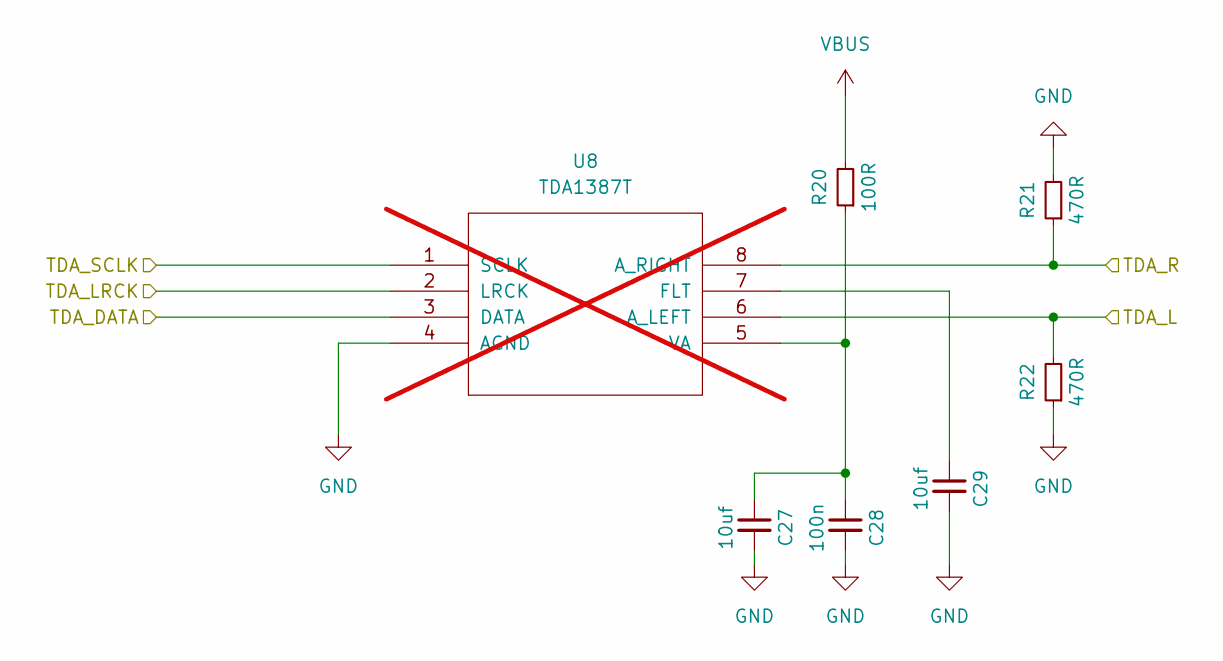
[picture p31: schematic tda.kicad_sch, ${NAME}]

Parts:
C27, C29: 10uf; C_0402_1005Metric; LCSC Part # C77000
C28: 100n; C_0402_1005Metric; LCSC Part # C1525
R20: 100R; R_0402_1005Metric; LCSC Part # C25076
R21, R22: 470R; R_0402_1005Metric; LCSC Part # C25117
U8: TDA1387T; SO-8; not fitted

Connections:
/Audio/TDA_DATA: U8.3 (DATA); also elsewhere on the board
/Audio/TDA_L: R22.2, U8.6 (A_LEFT); also elsewhere on the board
/Audio/TDA_LRCK: U8.2 (LRCK); also elsewhere on the board
/Audio/TDA_R: R21.1, U8.8 (A_RIGHT); also elsewhere on the board
/Audio/TDA_SCLK: U8.1 (SCLK); also elsewhere on the board
GND: C27.2, C28.2, C29.2, R21.2, R22.1, U8.4 (AGND); also elsewhere on the board
unnamed: C29.1, U8.7 (FLT)
unnamed: C27.1, C28.1, R20.1, U8.5 (VA)
VBUS: R20.2; also elsewhere on the board

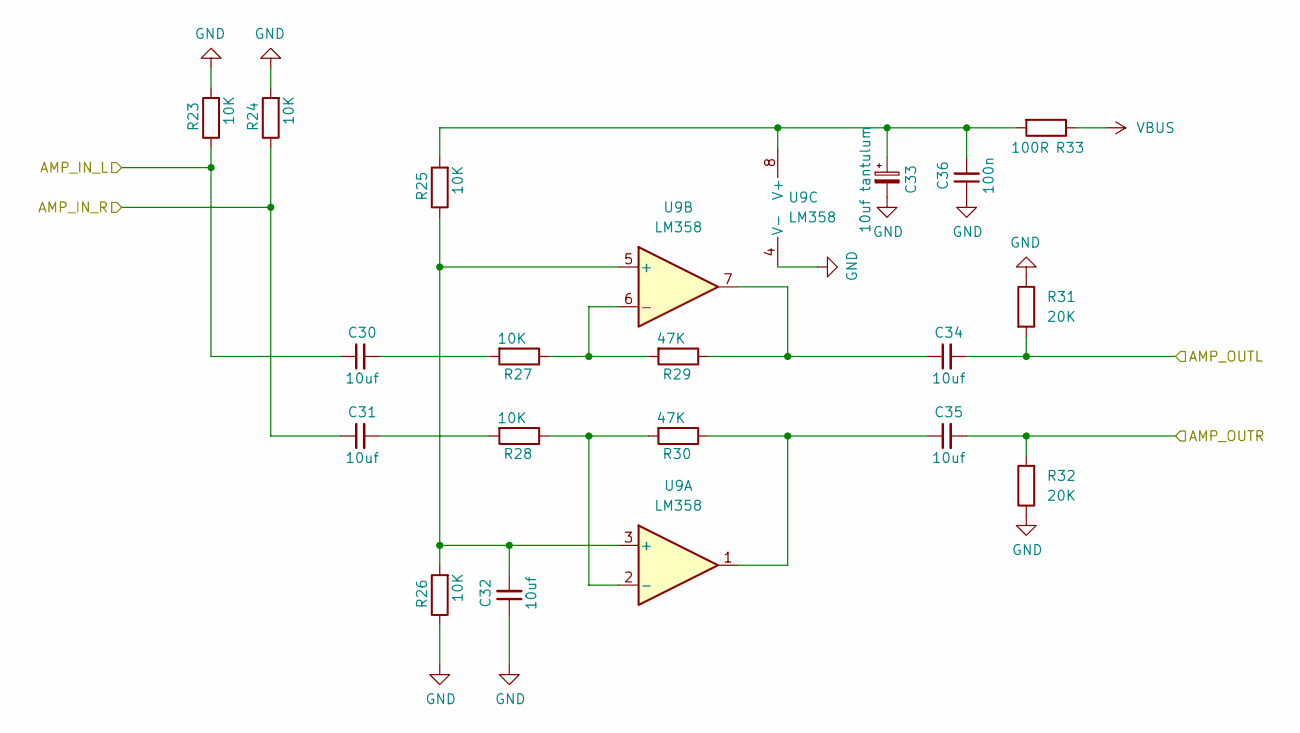
[picture p32: schematic amp.kicad_sch, ${NAME}]

Parts:
C30, C31, C32, C34, C35: 10uf; C_0402_1005Metric; LCSC Part # C77000
C33: 10uf tantulum; CP_EIA-3216-18_Kemet-A; LCSC Part # C7171
C36: 100n; C_0402_1005Metric; LCSC Part # C1525
R23, R24, R25, R26, R27, R28: 10K; R_0402_1005Metric; LCSC Part # C25744
R29, R30: 47K; R_0402_1005Metric; LCSC Part # C25792
R31, R32: 20K; R_0402_1005Metric; LCSC Part # C25765
R33: 100R; R_0402_1005Metric; LCSC Part # C25076
U9: LM358; SO-8; LCSC Part # C7950

Connections:
/Audio/AMP_OUTL: C34.2, R31.2; also elsewhere on the board
/Audio/AMP_OUTR: C35.2, R32.2; also elsewhere on the board
/Audio/TDA_L: C30.1, R23.1; also elsewhere on the board
/Audio/TDA_R: C31.1, R24.1; also elsewhere on the board
GND: C32.1, C33.2, C36.1, R23.2, R24.2, R26.1, R31.1, R32.1, U9.4 (V-); also elsewhere on the board
unnamed: C30.2, R27.2
unnamed: C31.2, R28.2
unnamed: C34.1, R29.1, U9.7
unnamed: C35.1, R30.1, U9.1
unnamed: C32.2, R25.1, R26.2, U9.3 (+), U9.5 (+)
unnamed: R28.1, R30.2, U9.2 (-)
unnamed: R27.1, R29.2, U9.6 (-)
unnamed: C33.1, C36.2, R25.2, R33.2, U9.8 (V+)
VBUS: R33.1; also elsewhere on the board

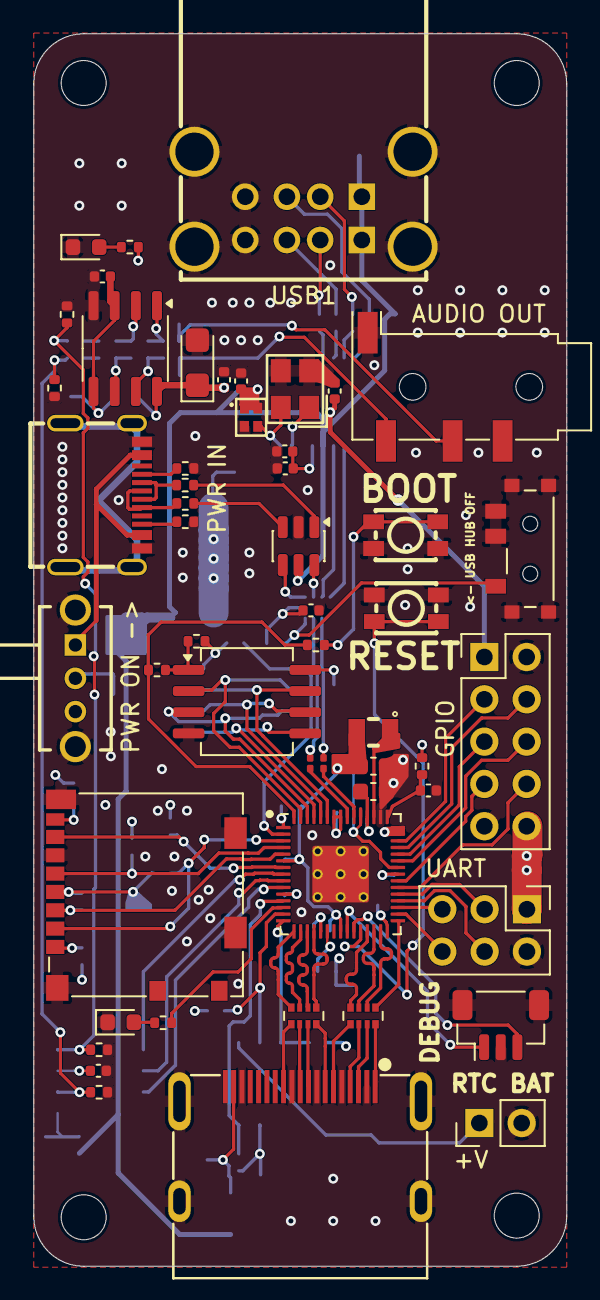
[picture p33: board frankless.kicad_pcb from above]

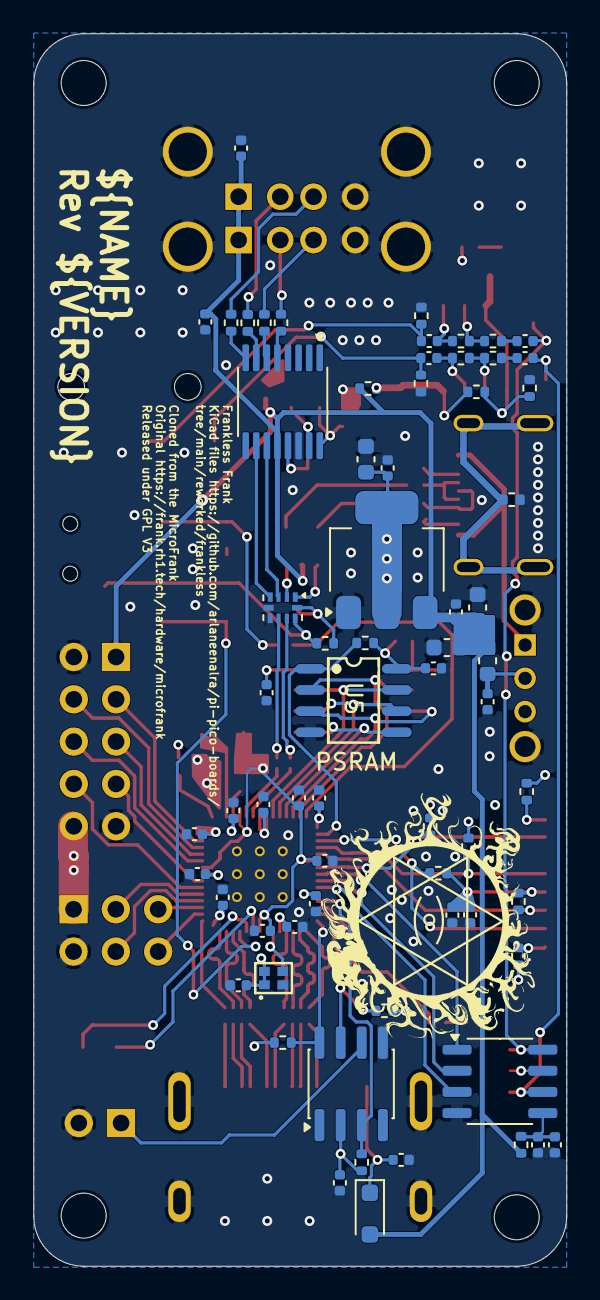
[picture p34: board frankless.kicad_pcb from below]

Board: 4 copper layers, 32.0 x 74.0 mm, 123 parts (67 on the bottom side), 105 nets.
