arlaneenalra/pi-pico-boards/(commit log)

2026-10-11 Add in the frankless board.
    [AudioJack_3.5mm_PJ320D.step, AudioJack_3.5mm_PJ320D_AudioOut.step, Button_SMD_3x4x2mm.step, CRYSTAL-SMD_4P-L3.2-W2.5-BL.step, ESP-01S.step, HDMI-SMD_A111926-B-01-R.step, HDMI_Female.step, Inductor_2016.step]
2026-10-11 A bit of clean up for things that don't make sense with the new layout yet
    [RealTimeClock.kicad_sch, amp.kicad_sch, audio.kicad_sch, button.kicad_sch, frankless.kicad_pcb, frankless.kicad_sch, hdmi.kicad_sch, power.kicad_sch]
2026-10-11 Patch a few minor issues.
    [frankless.kicad_pcb, frankless.kicad_sch, power.kicad_sch, rp2350a.kicad_sch]
2026-10-12 More cleanup.
    [RealTimeClock.kicad_sch, frankless.kicad_pcb, frankless.kicad_sch, rtc.kicad_sch, sd.kicad_sch]
2026-10-12 Fix name text.
    [frankless.kicad_pcb]
2026-10-12 Add in the missng production files.
    [bom.csv, designators.csv, positions.csv]
2026-10-12 Fix a few parts.
    [power.kicad_sch, rp2350a.kicad_sch, sd.kicad_sch]
2026-10-12 Fixing bad footprint matches.
    [RealTimeClock.kicad_sch, USB-A-TH_AF-SS-JB17.6.step, USB-C_SMD-TYPE-C-31-M-12_1.step, amp.kicad_sch, audio.kicad_sch, bom.csv, button.kicad_sch, designators.csv]
2026-10-12 More PCB layout clean ups.
    [USB-C-SMD_GT-USB-7010B.step, bom.csv, designators.csv, frankless.kicad_pcb, positions.csv, power.kicad_sch, sd.kicad_sch]
2026-10-22 Fix reset and boot button.
    [button.kicad_sch, frankless.kicad_pcb, positions.csv]
2026-10-24 Clean up old gerbers.
