arlaneenalra/pi-pico-boards/(notices)

Notices in the files:
reworked/frankless/frankless.kicad_pcb:
Released under GPL V3
